RainerWinkler/CO2-Measurement-simple/CO2Monitor3/CO2Monitor3.md

# CO2 Monitor 3

In a self made case

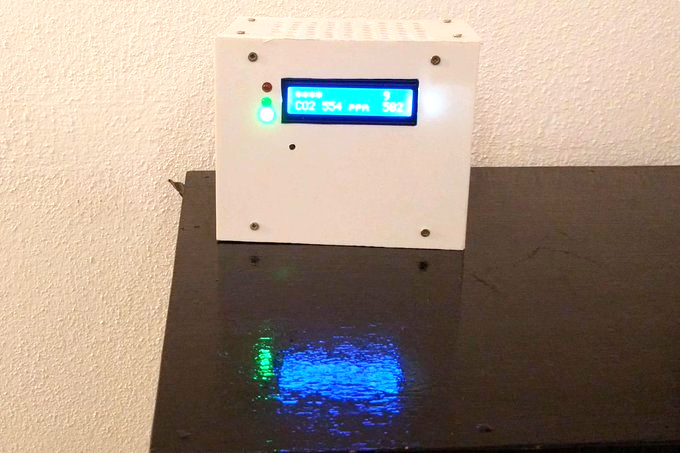
[picture p8: CO2Monitor3/Monitor2InCase.png]


This design has:
* Green, yellow and red warning lights
* Display
  * CO2 level is displayed
  * bar graph to visualize the CO2 level
* logic to enable it to be powered by a powerbank which auto power off
* Option to deactivate self calibration
* Option to calibrate at 400 ppm CO2 concentration
* Logging of CO2 concentration







# Circuit diagram

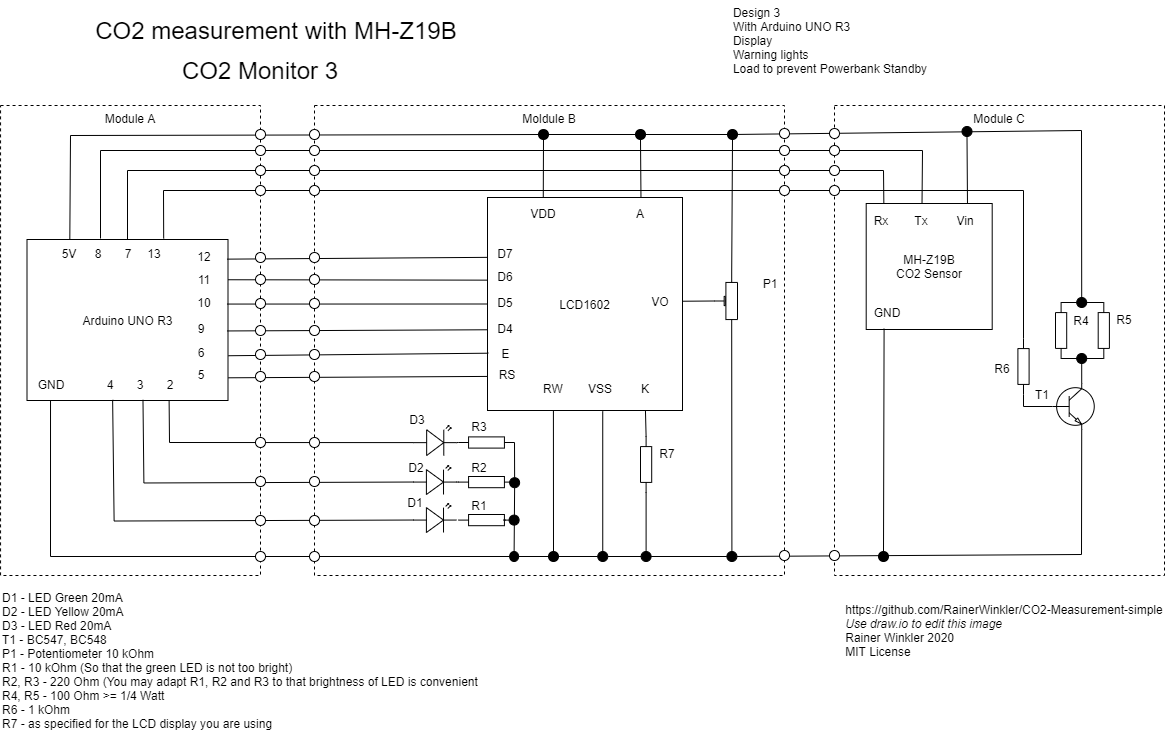
[picture p9: CO2Monitor3/CircuitDiagramCO2Monitor3.png]


[Back to top](../README.md)
