RainerWinkler/CO2-Measurement-simple/CO2Monitor3/CircuitDiagramCO2Monitor3_Vers1.png

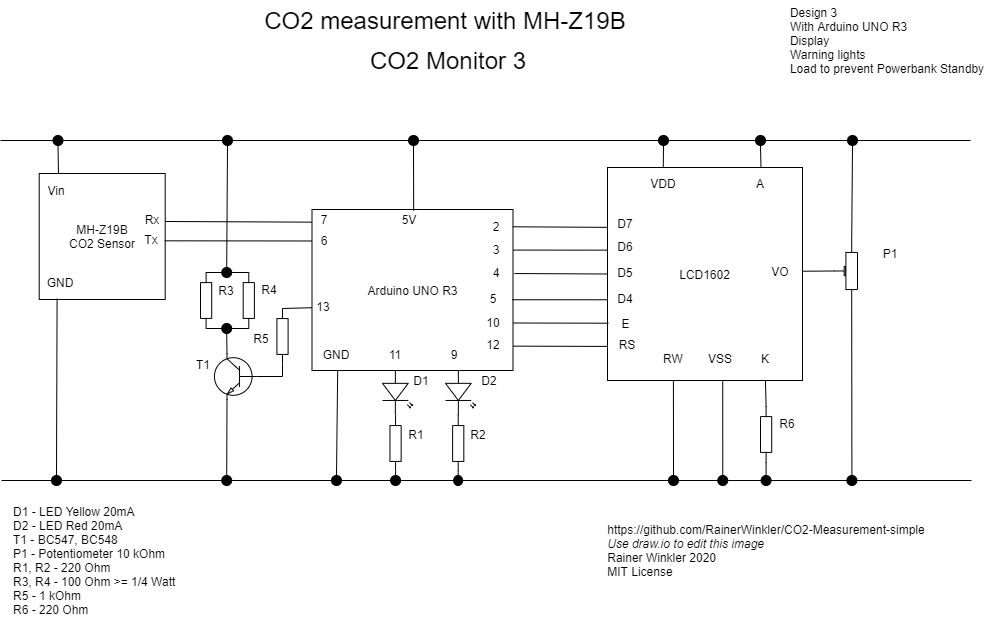
CO2Monitor3/CircuitDiagramCO2Monitor3_Vers1.png
