RainerWinkler/CO2-Measurement-simple/CO2Monitor2/WiringVerySimpleCO2Measurement.JPG

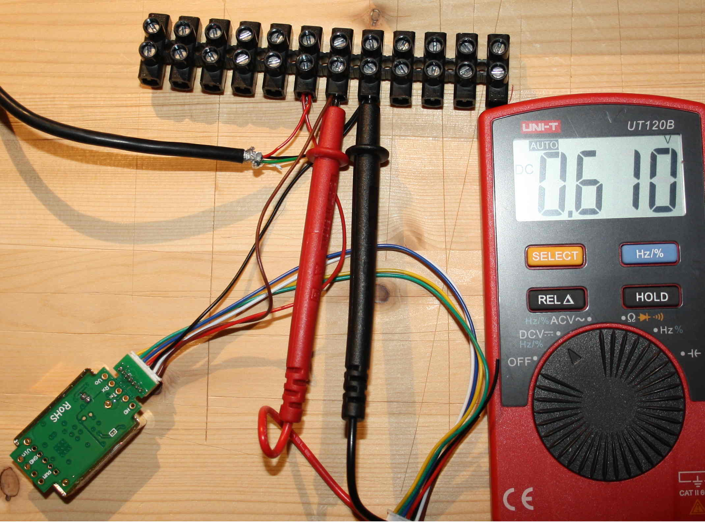
CO2Monitor2/WiringVerySimpleCO2Measurement.JPG
