RainerWinkler/CO2-Measurement-simple/CO2Monitor2/VerySimpleCO2MeasurementFinishedBottom.JPG

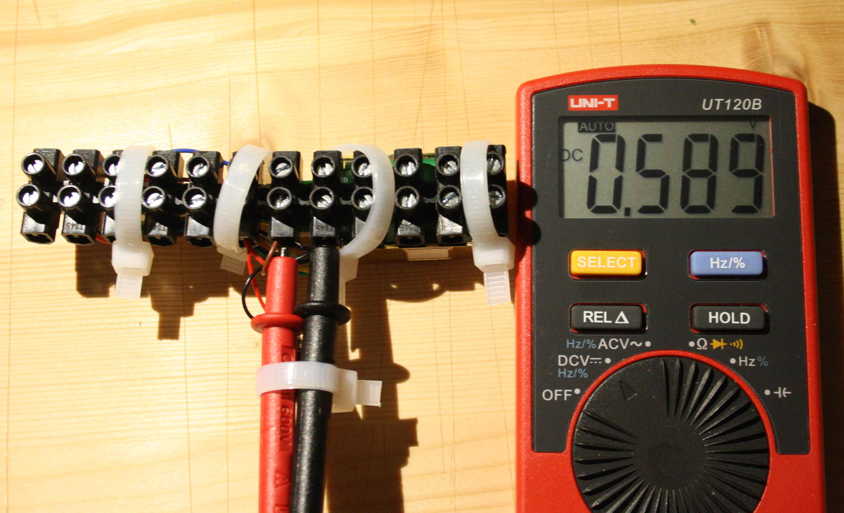
CO2Monitor2/VerySimpleCO2MeasurementFinishedBottom.JPG
