RainerWinkler/CO2-Measurement-simple/CO2Monitor2/VerySimpleCO2MeasurementFinishedTop.JPG

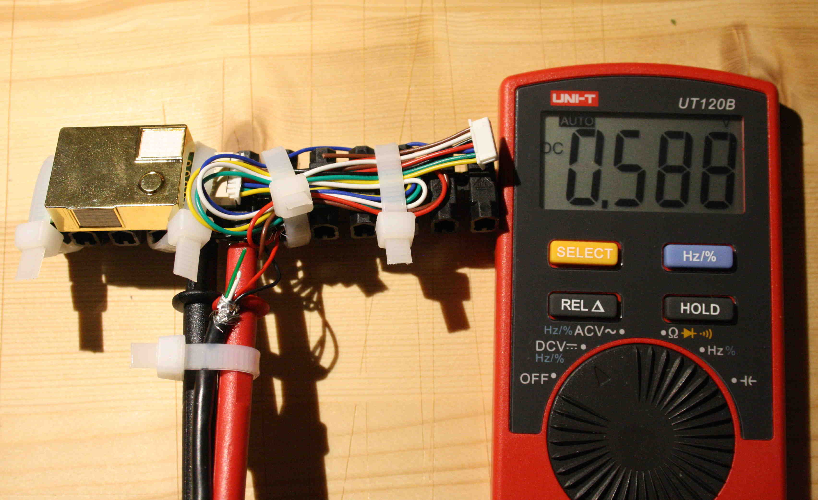
CO2Monitor2/VerySimpleCO2MeasurementFinishedTop.JPG
