RainerWinkler/CO2-Measurement-simple/(threads)

Thread 3 (2020-09-03):

The green LED is too bright

RainerWinkler, 2020-09-03:

RainerWinkler, 2020-09-03:
Reduce the current of the green LED. Replace 220 Ohm with 1kOhm resistor

Closed 2020-09-18.

Thread 4 (2020-09-09):

Reading of concentration changes when supply voltage changes

RainerWinkler, 2020-09-09:
When the voltage is not stabilized as currently in Model 3 the displayed CO2 concentration changes for a few minutes when the supply voltage changes. This may happen for instance by activating a fan. The concentration returns to a value close to the original value. This is probably due to an internal compensation routine in the MH-Z19B sensor.

It is unclear whether the option to use a stable supply voltage should be provided.

My impression is, that this behaviour is acceptable for the application as a room ventilation monitoring device during the pandemic.

Thread 11 (2020-09-18):

Prevent problems after 49 days in model 3

RainerWinkler, 2020-09-18:
Handle the rollover of millis() in model 3 correctly. As for instance described here: https://www.baldengineer.com/arduino-how-do-you-reset-millis.html

RainerWinkler, 2020-09-18:
The fix has to assure that the rollover works correctly. To do this do not use millis() directly but add a very high value to millis() and use this value. Do this in a way that the rollover takes place about a minute after starting the program. Any errors due to the rollover will than occur immidiately after start. This will lead to a good test coverage of the rollover.

Thread 9 (2020-09-18):

Commands via serial interface sometimes incomplete

RainerWinkler, 2020-09-18:
As a workaround, commands are kept short.

RainerWinkler, 2020-09-18:
As described here, wait 1 milliseconds between reading a character: https://stackoverflow.com/questions/9901058/arduino-cant-read-serial-properly/11680065

Closed 2020-09-18.
