RainerWinkler/CO2-Measurement-simple/(commit log)

2020-08-21 Add switches to tune amplification
2020-08-21 Add Impedance coupler to 0.4 reference voltage
2020-08-21 Add option to measure unchanged sensor output voltage
2020-08-22 Explain how the range is checked with a simple calibration
2020-08-25 Add measurement point for ground
2020-08-26 Images of Very Simple CO2 Measurement Prototype
2020-08-30 New Circuit Diagram Design 3
2020-08-31 Switch pin 10 and 11
    Required for platine layout
2020-09-01 Correct error Tx is connected to pin 6 not 7 and vice versa
2020-09-02 Backup Version 1 of Circuit Diagram
2020-09-02 Split circuit into modules
2020-09-03 #3 Reduce brightness of green LED
    Replace R1 with 1kOhm do make green light less bright
2020-09-03 #3 10kOhm for green LED
2020-09-03 #2 Adapt comment to make visible what was changed
    The first commit was to the wrong issue
    [CO2Monitor3.ino]
2020-09-04 Changed pins due to different prototype layout
2020-09-13 Switch Baudrate to 115200 for monitoring
2020-09-13 the type of millis() is unsigned long
    Adapt type which refer to millis
2020-09-13 Use short integer for ppm values
    To prepare logic to store ppm values use short integer as this is sufficient
    [CO2Monitor3.ino]
2020-09-14 #5 Correct error in logging intervall logic
    [CO2Monitor3.ino]
2020-09-14 #6 Activate and deactivate self calibration and cleanup
2020-09-14 #7 Allow calibration of - #6 correct error
    [CO2Monitor3.ino]
2020-09-14 New image Model 3 with case
2020-09-17 Use F() function for strings to save memory
    As described here https://www.arduino.cc/reference/de/language/variables/utilities/progmem/
2020-09-18 #8 Fix bug in displayed log intervall at start
    [CO2Monitor3.ino]
2020-09-18 #8 Display logged intervall with log - Small Improvements
    Write that it is started as text in log display
    Use 1000UL to prevent wrong conversions
    [CO2Monitor3.ino]
2020-09-18 #9 Wait 1 millisecond to read complete
2020-09-18 #10 correct error for logsec statement
    [CO2Monitor3.ino]
2020-09-26 Green with 1kOhm Resistor
2020-09-26 Make a statement about the reliability of the sensor
2020-09-27 #3 korrekt green LED resistor - R7 as specified for LCD
